Darkzveller/Stepper-Herkulex-CAN-F303K8/Kicad/CarteMPPIndus/ALTIUM_EMBEDDED_MODELS/LED 0603.STEP

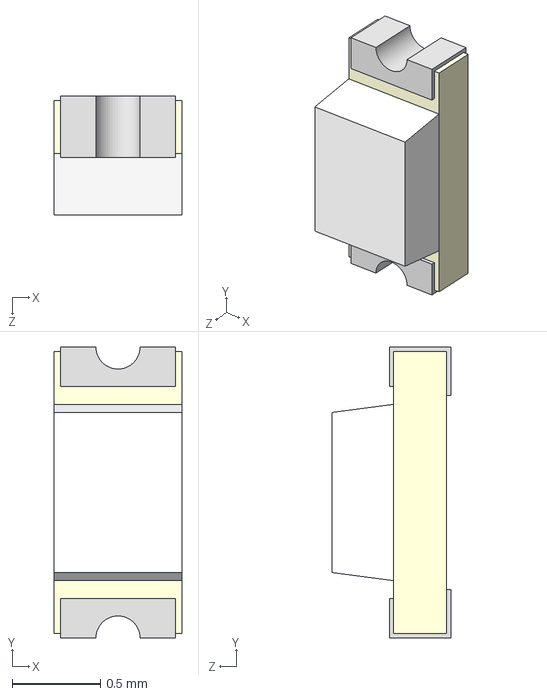
[picture p1: CAD file, 2025-05-03]
Kicad/CarteMPPIndus/ALTIUM_EMBEDDED_MODELS/LED 0603.STEP
0.725 x 1.65 x 0.675 mm
