Darkzveller/Stepper-Herkulex-CAN-F303K8/Kicad/CarteMPPIndus/LibGe2/3D/FTSH-105-01-L-DV-K.step

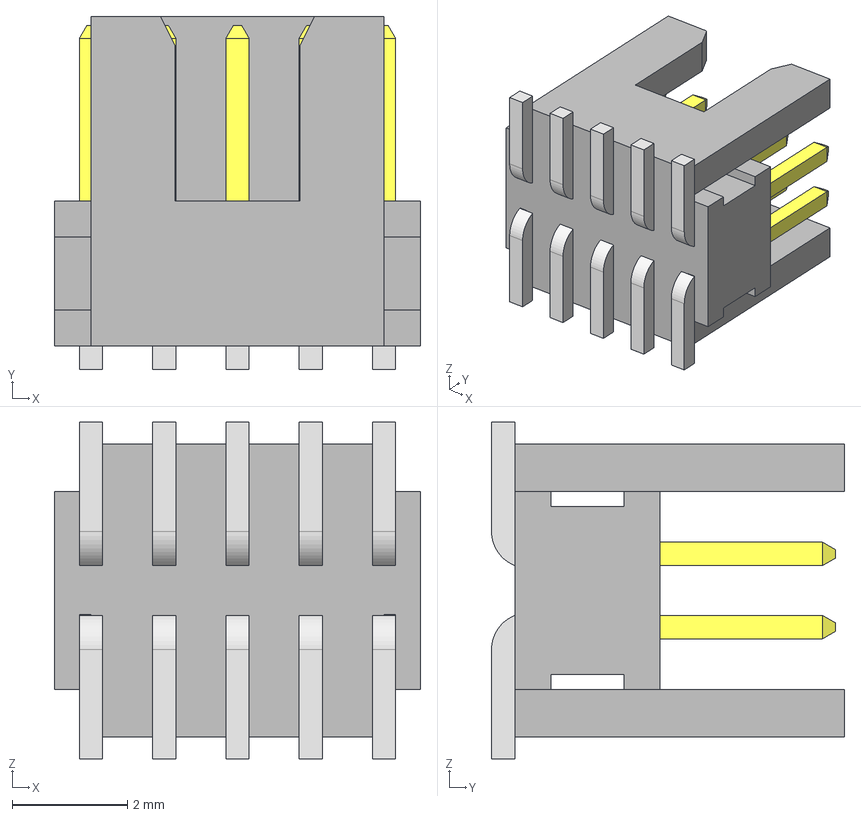
[picture p3: CAD file, 2025-05-03]
Kicad/CarteMPPIndus/LibGe2/3D/FTSH-105-01-L-DV-K.step
6.35 x 6.12 x 5.84 mm
FTSH-105-01-L-DV-K_body
FTSH-105-01-L-DV-K_pins1
FTSH-105-01-L-DV-K_pins2
