Darkzveller/Stepper-Herkulex-CAN-F303K8/Kicad/CarteMPPIndus/STM32F303K8T6/STM32F303K8T6.step

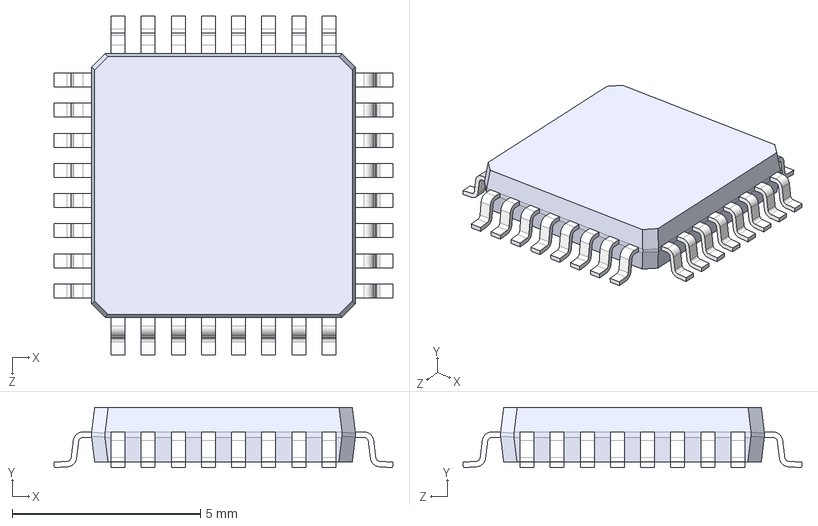
[picture p4: CAD file, 2025-05-03]
Kicad/CarteMPPIndus/STM32F303K8T6/STM32F303K8T6.step
9.00 x 1.60 x 9.00 mm
