Darkzveller/Stepper-Herkulex-CAN-F303K8/Kicad/CarteMPPIndus/STSPIN820/STSPIN820.step

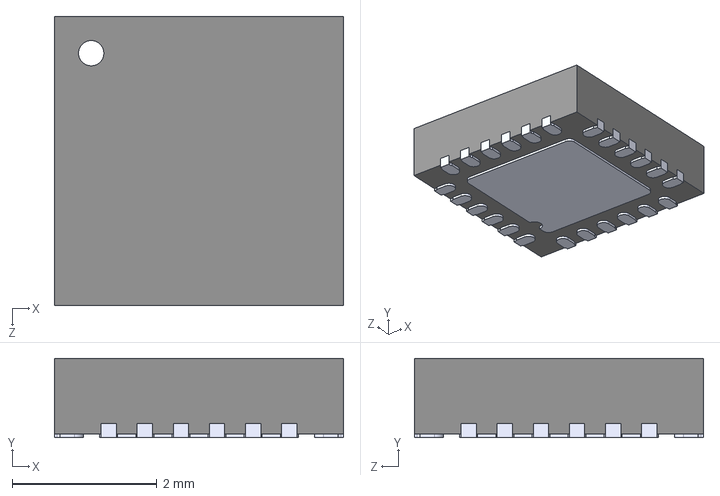
[picture p5: CAD file, 2025-05-03]
Kicad/CarteMPPIndus/STSPIN820/STSPIN820.step
4.00 x 1.10 x 4.00 mm
