Darkzveller/Stepper-Herkulex-CAN-F303K8/Kicad/Extension_Pompes/LibGamelGe2_v6/3D/BNC.STEP

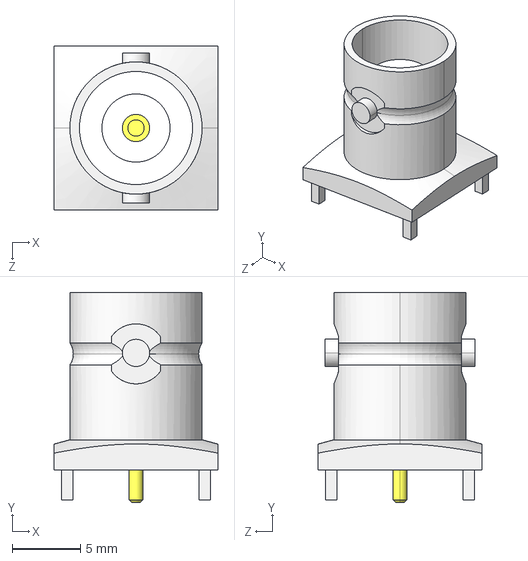
[picture p7: CAD file, 2025-02-12]
Kicad/Extension_Pompes/LibGamelGe2_v6/3D/BNC.STEP
12.0 x 15.4 x 12.0 mm
