Darkzveller/Stepper-Herkulex-CAN-F303K8/Kicad/Kicad_Pince KICAD V7/ALTIUM_EMBEDDED_MODELS/IC_Microchip_24LC1025T-I-SN_eec.STEP

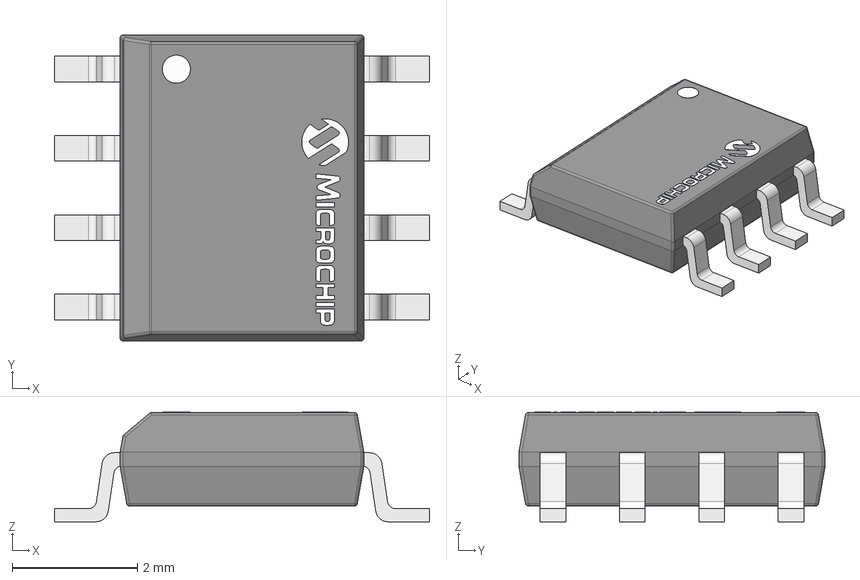
[picture p8: CAD file, 2025-02-12]
Kicad/Kicad_Pince KICAD V7/ALTIUM_EMBEDDED_MODELS/IC_Microchip_24LC1025T-I-SN_eec.STEP
6.00 x 4.90 x 1.75 mm
pins
logo1
