Darkzveller/Stepper-Herkulex-CAN-F303K8/Kicad/CarteMPPIndus/ALTIUM_EMBEDDED_MODELS/0603 SMD Resistor.stp

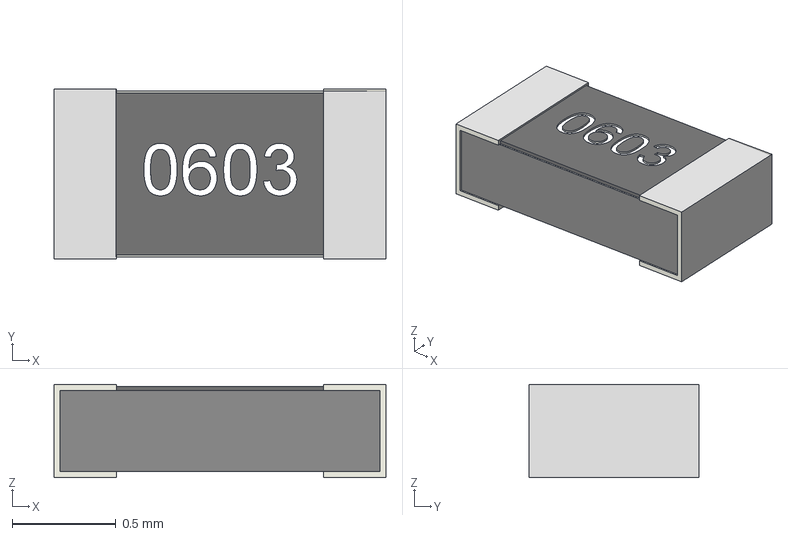
[picture p9: CAD file, 2025-05-03]
Kicad/CarteMPPIndus/ALTIUM_EMBEDDED_MODELS/0603 SMD Resistor.stp
1.60 x 0.82 x 0.45 mm
