Darkzveller/Stepper-Herkulex-CAN-F303K8/Kicad/Extension_Pompes/LibGamelGe2_v6/3D/OmnimateSL_1x04.STEP

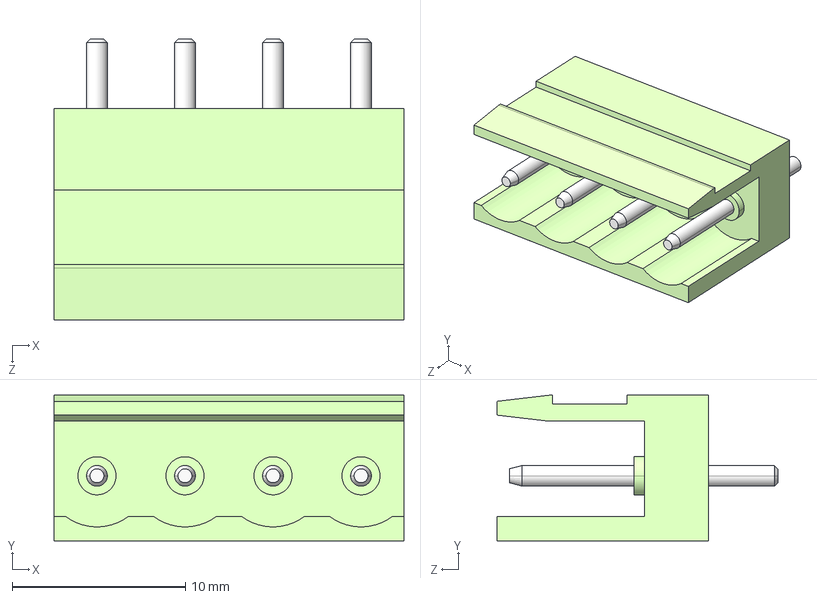
[picture p10: CAD file, 2025-02-12]
Kicad/Extension_Pompes/LibGamelGe2_v6/3D/OmnimateSL_1x04.STEP
20.2 x 8.40 x 16.2 mm
