Darkzveller/Stepper-Herkulex-CAN-F303K8/Kicad/CarteMPPIndus/ALTIUM_EMBEDDED_MODELS/User Library-SOIC-8-1.STEP

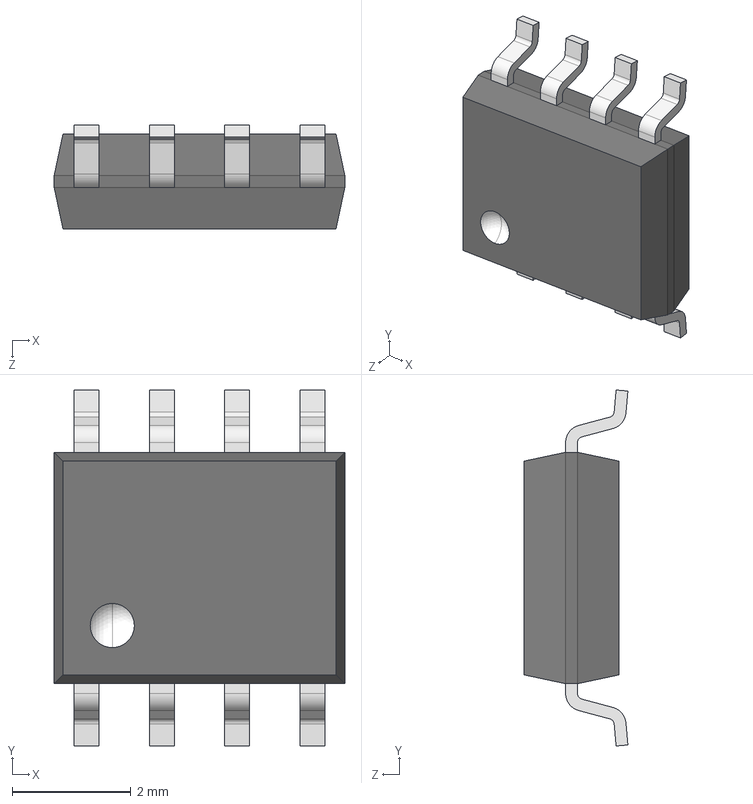
[picture p11: CAD file, 2025-05-03]
Kicad/CarteMPPIndus/ALTIUM_EMBEDDED_MODELS/User Library-SOIC-8-1.STEP
4.90 x 6.00 x 1.75 mm
