Darkzveller/Stepper-Herkulex-CAN-F303K8/Kicad/Extension_Pompes/LibGamelGe2_v6/3D/C_Rect_L19.0mm_W5.0mm_P15.00mm.STEP

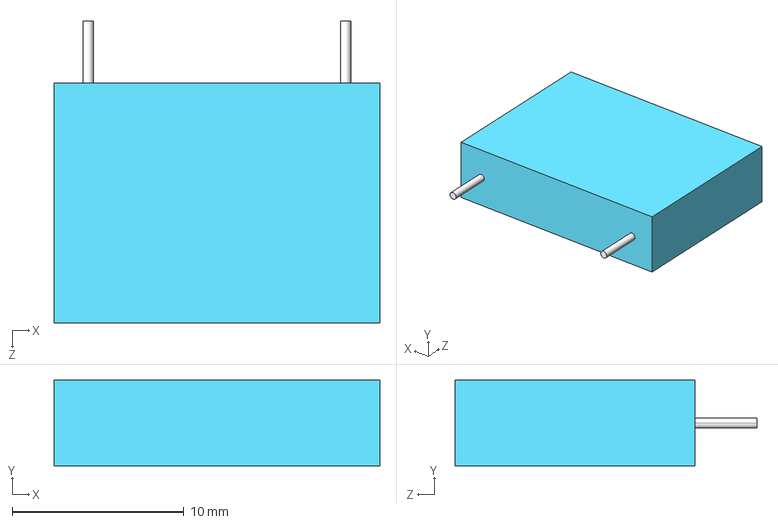
[picture p12: CAD file, 2025-02-12]
Kicad/Extension_Pompes/LibGamelGe2_v6/3D/C_Rect_L19.0mm_W5.0mm_P15.00mm.STEP
19.0 x 5.00 x 17.6 mm
