Darkzveller/Stepper-Herkulex-CAN-F303K8/Kicad/CarteMPPIndus/ALTIUM_EMBEDDED_MODELS/SOT95P240X110-3L.step

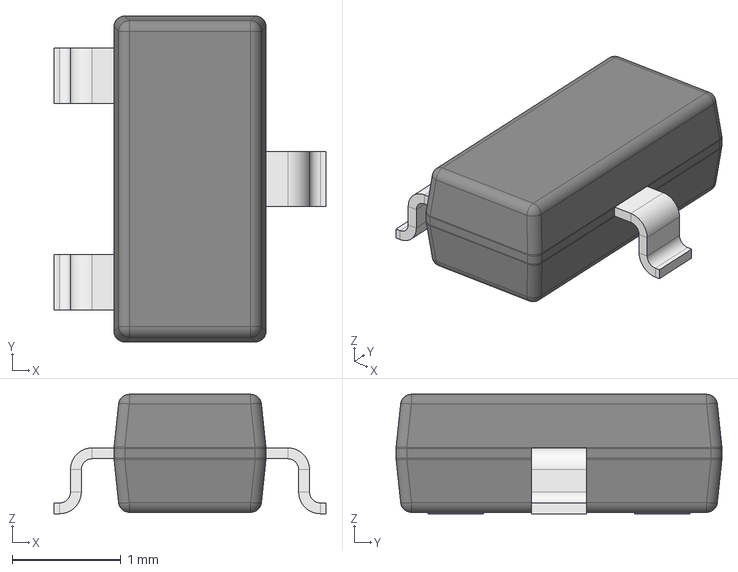
[picture p13: CAD file, 2025-05-03]
Kicad/CarteMPPIndus/ALTIUM_EMBEDDED_MODELS/SOT95P240X110-3L.step
2.50 x 3.00 x 1.10 mm
Leader x 3
