Darkzveller/Stepper-Herkulex-CAN-F303K8/Kicad/CarteMPPIndus/LibGe2/3D/Grove Connector (sit).STEP

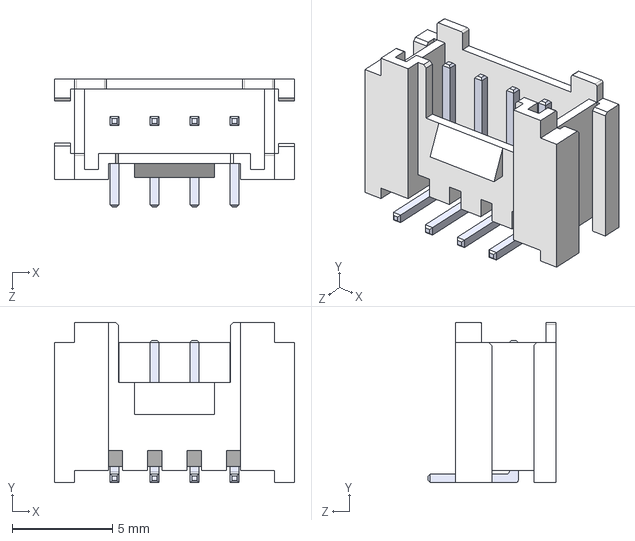
[picture p14: CAD file, 2025-02-12]
Kicad/CarteMPPIndus/LibGe2/3D/Grove Connector (sit).STEP
12.0 x 8.00 x 6.38 mm
