Darkzveller/Stepper-Herkulex-CAN-F303K8/Kicad/Extension_Pompes/LibGamelGe2_v6/3D/C_Rect_L4.0mm_W2.5mm_P2.50mm.STEP

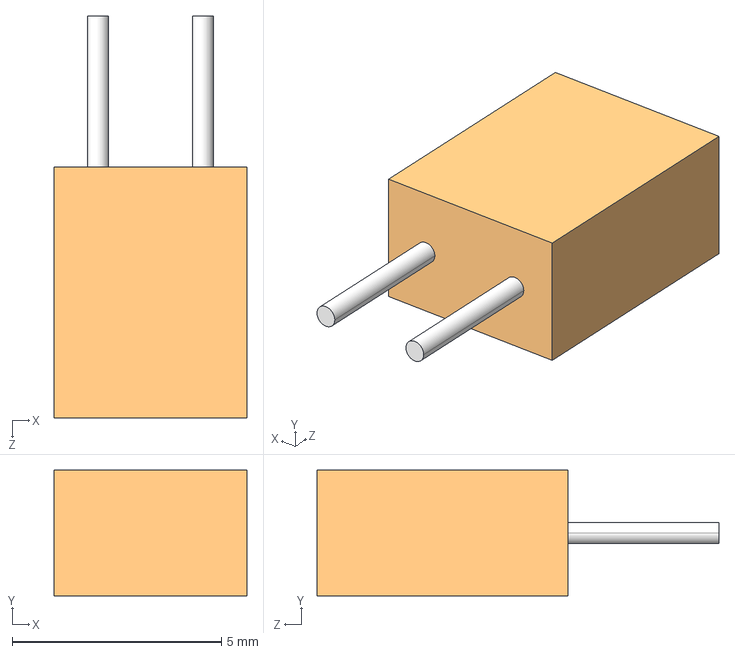
[picture p15: CAD file, 2025-02-12]
Kicad/Extension_Pompes/LibGamelGe2_v6/3D/C_Rect_L4.0mm_W2.5mm_P2.50mm.STEP
4.60 x 3.00 x 9.60 mm
