Darkzveller/Stepper-Herkulex-CAN-F303K8/Kicad/CarteMPPIndus/ALTIUM_EMBEDDED_MODELS/SW3dPS-SOT-223-1.STEP

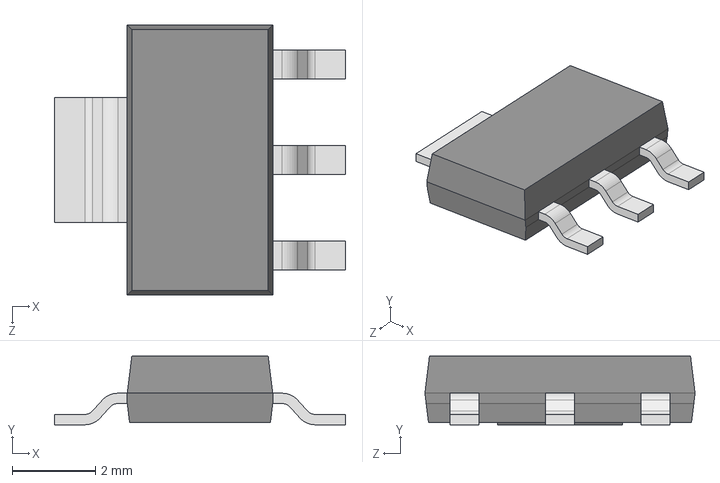
[picture p16: CAD file, 2025-05-03]
Kicad/CarteMPPIndus/ALTIUM_EMBEDDED_MODELS/SW3dPS-SOT-223-1.STEP
7.00 x 1.65 x 6.50 mm
