Darkzveller/Stepper-Herkulex-CAN-F303K8/Kicad/CarteMPPIndus/LibGe2/3D/pololu-2507.STEP

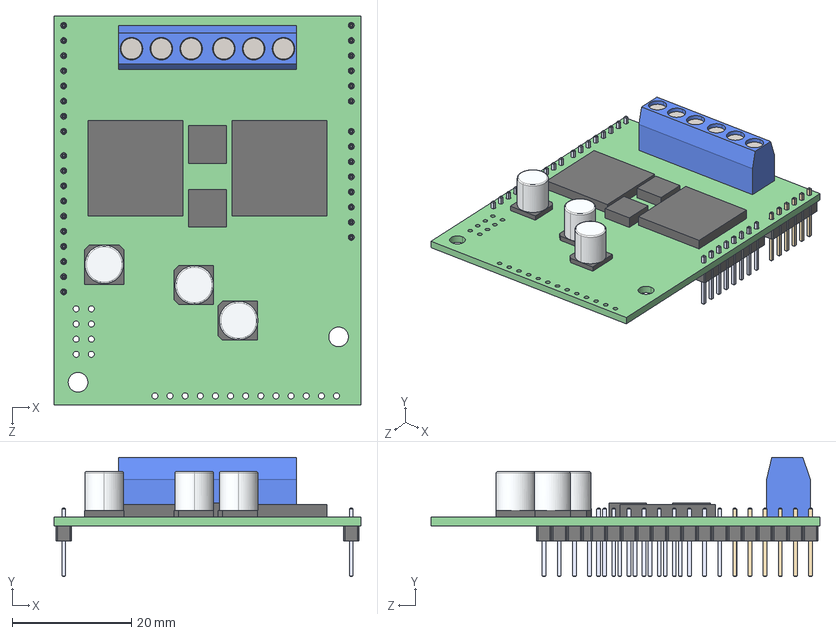
[picture p17: CAD file, 2025-02-12]
Kicad/CarteMPPIndus/LibGe2/3D/pololu-2507.STEP
51.4 x 20.0 x 65.3 mm
Pololu VNH5019 Motor Driver
PinHeader_1x06_P2.54mm_Vertical.step
PinHeader_1x08_P2.54mm_Vertical.step x 2
PinHeader_1x10_P2.54mm_Vertical.step
