Darkzveller/Stepper-Herkulex-CAN-F303K8/Kicad/Extension_Pompes/LibGamelGe2_v6/3D/SW_push_5mm_blue.STEP

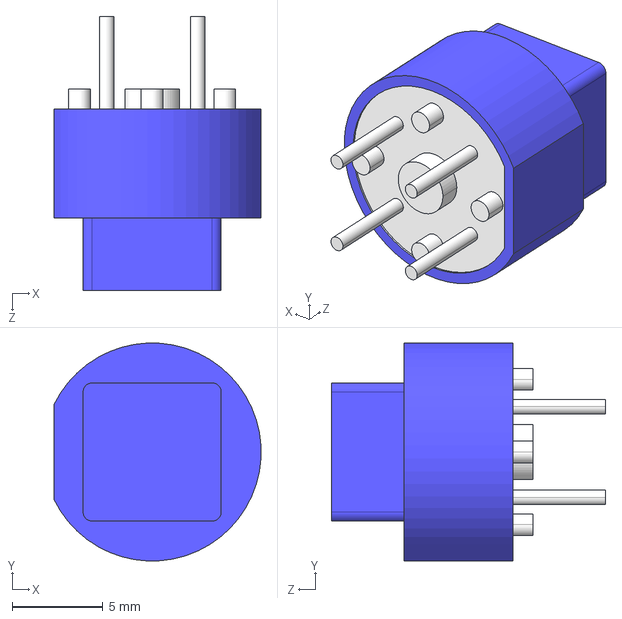
[picture p18: CAD file, 2025-02-12]
Kicad/Extension_Pompes/LibGamelGe2_v6/3D/SW_push_5mm_blue.STEP
11.4 x 12.0 x 15.1 mm
