Darkzveller/Stepper-Herkulex-CAN-F303K8/Kicad/CarteMPPIndus/ALTIUM_EMBEDDED_MODELS/Embase Micromatch Femelle CMS 8pts.stp

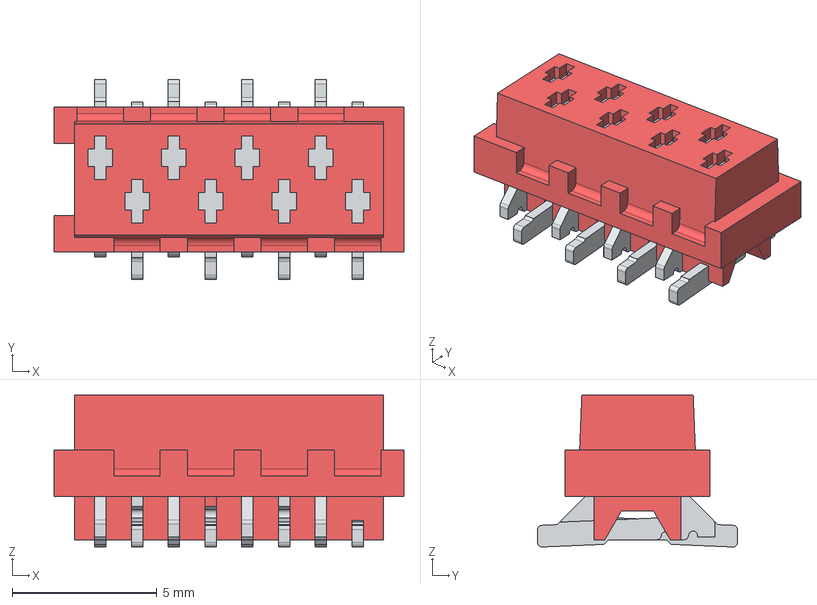
[picture p19: CAD file, 2025-02-12]
Kicad/CarteMPPIndus/ALTIUM_EMBEDDED_MODELS/Embase Micromatch Femelle CMS 8pts.stp
12.1 x 6.90 x 5.25 mm
