Darkzveller/Stepper-Herkulex-CAN-F303K8/Kicad/CarteMPPIndus/LibGe2/3D/Grove Connector (standing).STEP

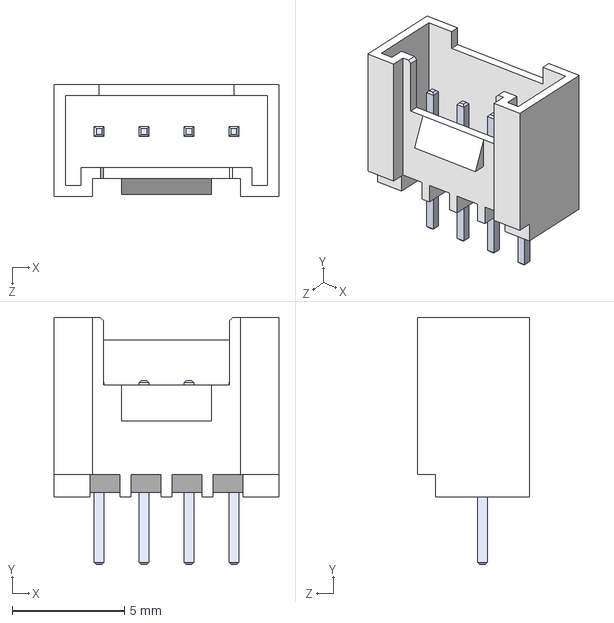
[picture p20: CAD file, 2025-02-12]
Kicad/CarteMPPIndus/LibGe2/3D/Grove Connector (standing).STEP
10.0 x 11.0 x 5.00 mm
