Darkzveller/Stepper-Herkulex-CAN-F303K8/Kicad/CarteMPPIndus/ALTIUM_EMBEDDED_MODELS/0603-C.STEP

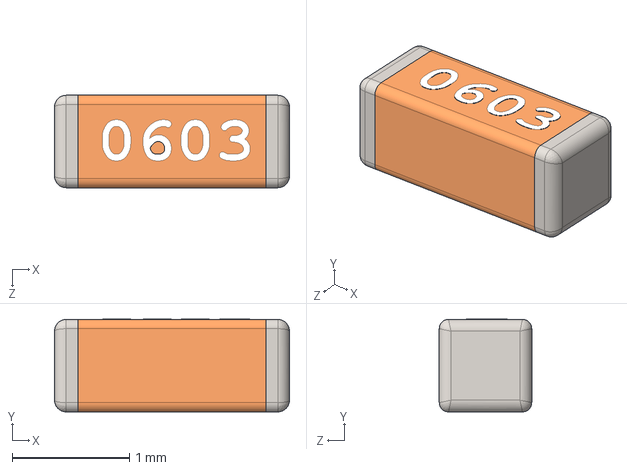
[picture p21: CAD file, 2025-02-12]
Kicad/CarteMPPIndus/ALTIUM_EMBEDDED_MODELS/0603-C.STEP
2.00 x 0.79 x 0.787 mm
