Darkzveller/Stepper-Herkulex-CAN-F303K8/Kicad/CarteMPPIndus/LibGe2/3D/Grove Connector (lying).STEP

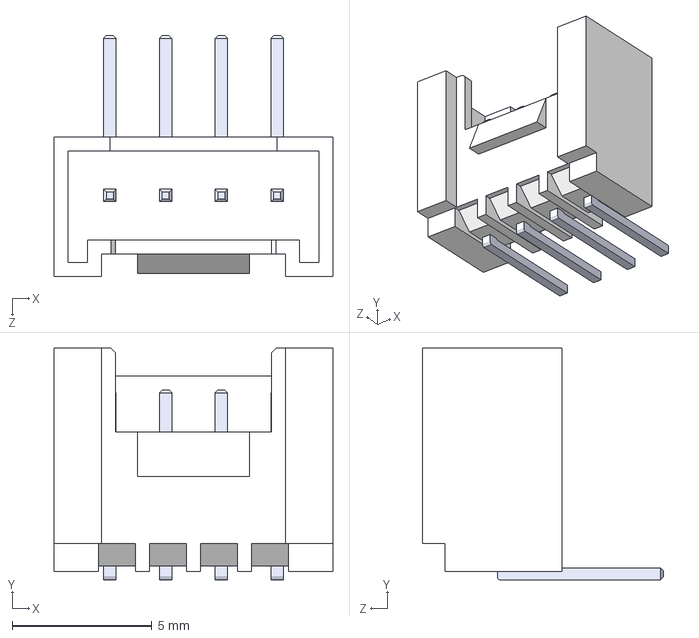
[picture p22: CAD file, 2025-02-12]
Kicad/CarteMPPIndus/LibGe2/3D/Grove Connector (lying).STEP
10.0 x 8.30 x 8.62 mm
