Darkzveller/Stepper-Herkulex-CAN-F303K8/Kicad/Extension_Pompes/LibGamelGe2_v6/3D/LED5mm_green.STEP

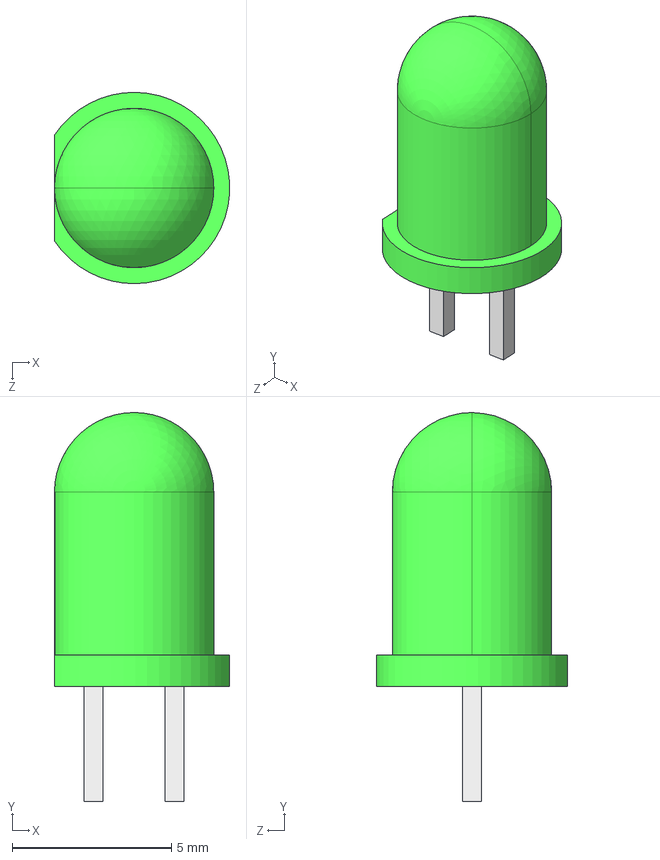
[picture p23: CAD file, 2025-02-12]
Kicad/Extension_Pompes/LibGamelGe2_v6/3D/LED5mm_green.STEP
5.49 x 12.2 x 6.00 mm
