Darkzveller/Stepper-Herkulex-CAN-F303K8/Kicad/CarteMPPIndus/LibGe2/3D/THN_15-1211N.step

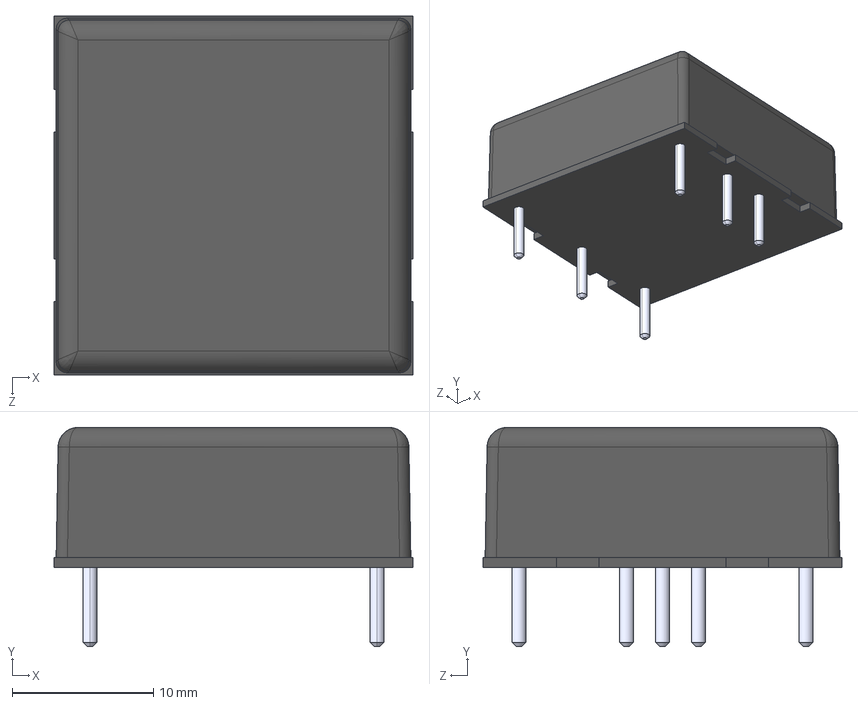
[picture p24: CAD file, 2025-02-12]
Kicad/CarteMPPIndus/LibGe2/3D/THN_15-1211N.step
25.4 x 15.5 x 25.4 mm
