Darkzveller/Stepper-Herkulex-CAN-F303K8/Kicad/Extension_Pompes/LibGamelGe2_v6/3D/HE10_2x8.STEP

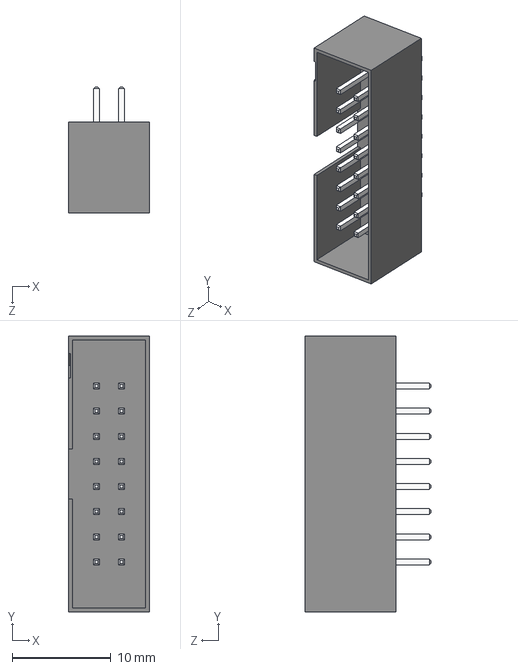
[picture p25: CAD file, 2025-02-12]
Kicad/Extension_Pompes/LibGamelGe2_v6/3D/HE10_2x8.STEP
8.20 x 27.9 x 12.7 mm
