Darkzveller/Stepper-Herkulex-CAN-F303K8/Kicad/CarteMPPIndus/LibGe2/3D/Grove Connector (flat).STEP

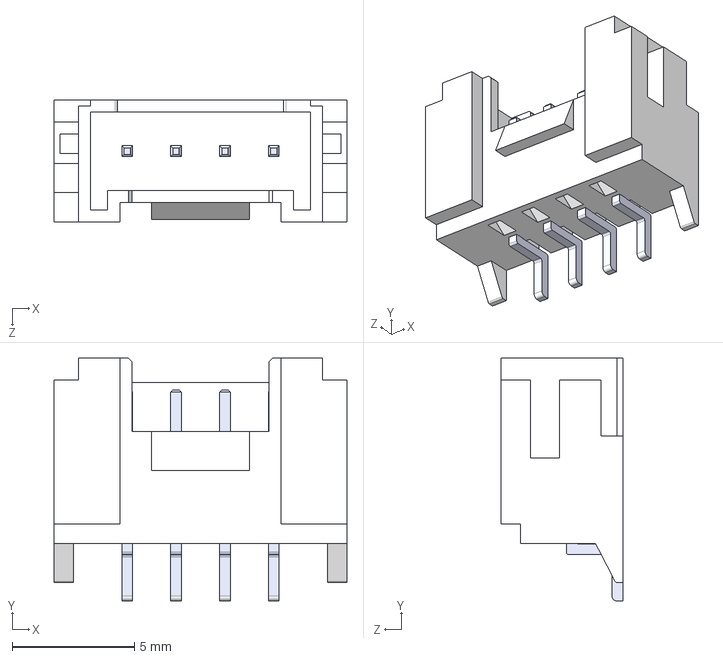
[picture p26: CAD file, 2025-02-12]
Kicad/CarteMPPIndus/LibGe2/3D/Grove Connector (flat).STEP
12.0 x 9.95 x 5.00 mm
