Darkzveller/Stepper-Herkulex-CAN-F303K8/Kicad/Extension_Pompes/LibGamelGe2_v6/3D/LED3mm_green.STEP

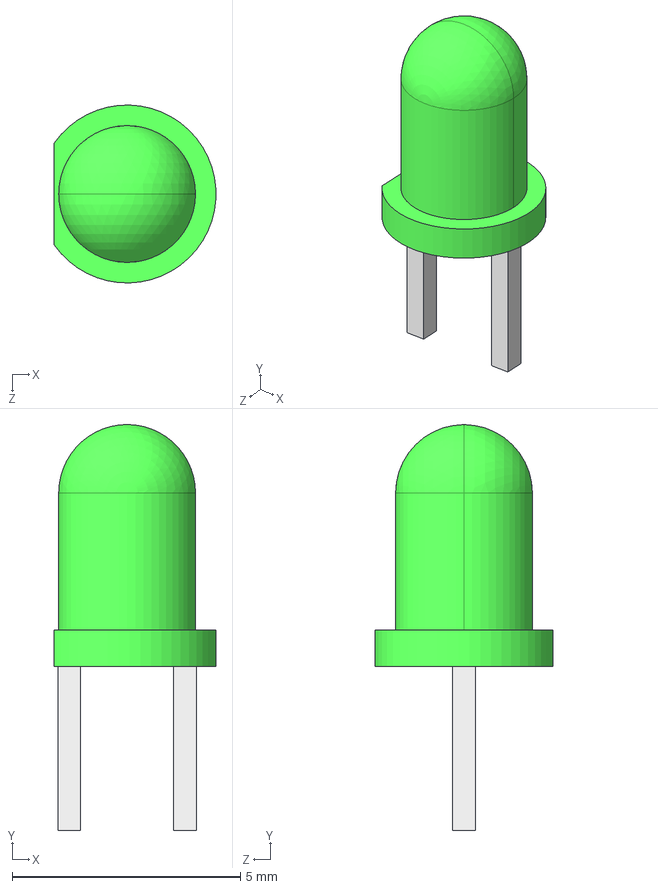
[picture p28: CAD file, 2025-02-12]
Kicad/Extension_Pompes/LibGamelGe2_v6/3D/LED3mm_green.STEP
3.55 x 8.90 x 3.90 mm
