Darkzveller/Stepper-Herkulex-CAN-F303K8/Kicad/Extension_Pompes/LibGamelGe2_v6/3D/C_Rect_L28.0mm_W8.0mm_P22.50mm.STEP

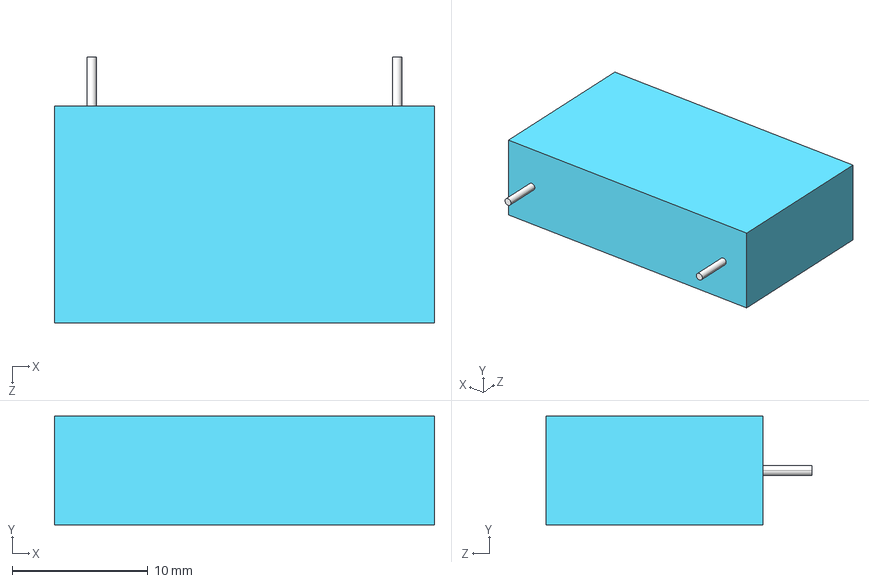
[picture p29: CAD file, 2025-02-12]
Kicad/Extension_Pompes/LibGamelGe2_v6/3D/C_Rect_L28.0mm_W8.0mm_P22.50mm.STEP
28.0 x 8.00 x 19.6 mm
