Darkzveller/Stepper-Herkulex-CAN-F303K8/Kicad/Extension_Pompes/LibGamelGe2_v6/3D/autocom4.STEP

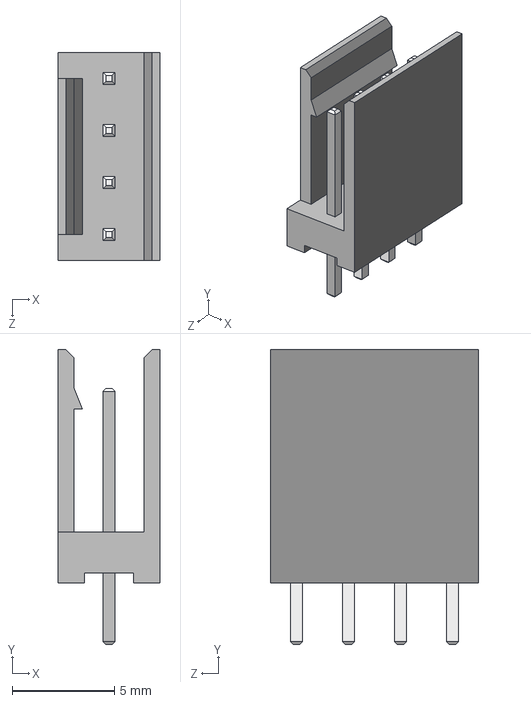
[picture p30: CAD file, 2025-02-12]
Kicad/Extension_Pompes/LibGamelGe2_v6/3D/autocom4.STEP
5.00 x 14.4 x 10.2 mm
