Darkzveller/Stepper-Herkulex-CAN-F303K8/Kicad/Extension_Pompes/LibGamelGe2_v6/3D/HE10_2x5.STEP

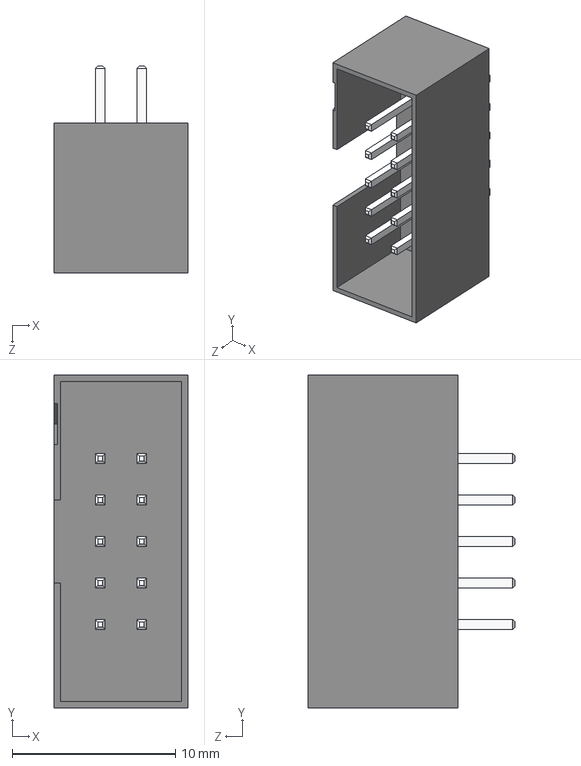
[picture p31: CAD file, 2025-02-12]
Kicad/Extension_Pompes/LibGamelGe2_v6/3D/HE10_2x5.STEP
8.20 x 20.4 x 12.7 mm
