Darkzveller/Stepper-Herkulex-CAN-F303K8/Kicad/Extension_Pompes/LibGamelGe2_v6/3D/TO220_horizontal.STEP

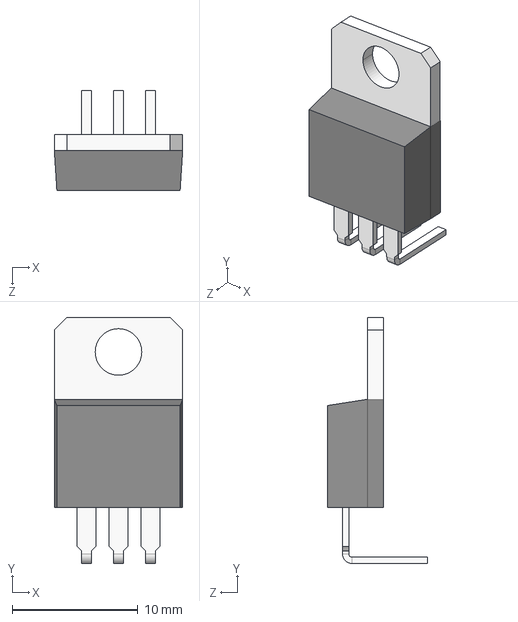
[picture p32: CAD file, 2025-02-12]
Kicad/Extension_Pompes/LibGamelGe2_v6/3D/TO220_horizontal.STEP
10.2 x 19.6 x 7.96 mm
