Darkzveller/Stepper-Herkulex-CAN-F303K8/Kicad/Extension_Pompes/LibGamelGe2_v6/3D/Potentiometer_Vertical.STEP

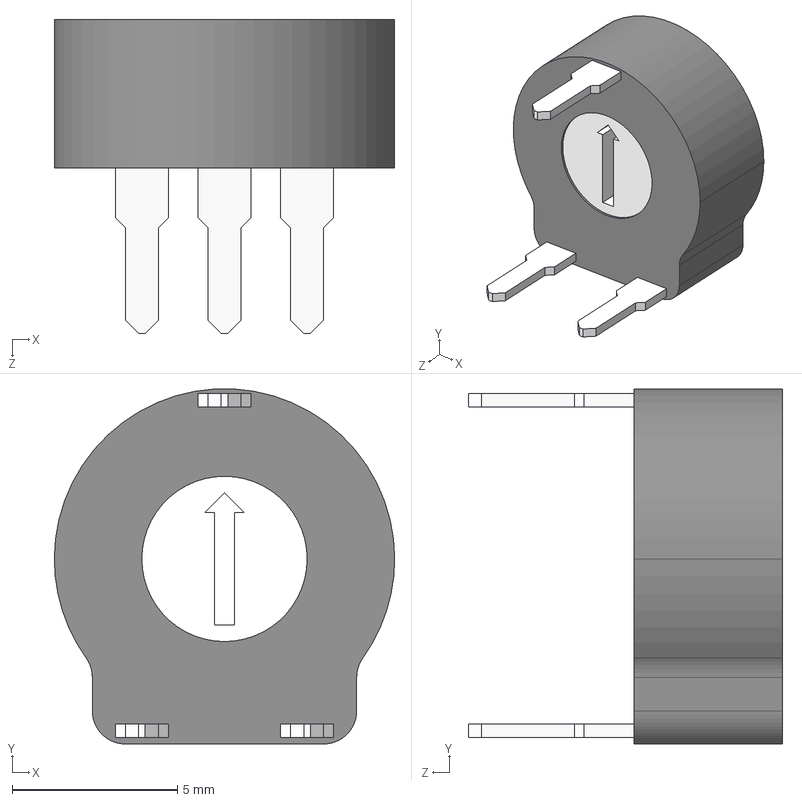
[picture p33: CAD file, 2025-02-12]
Kicad/Extension_Pompes/LibGamelGe2_v6/3D/Potentiometer_Vertical.STEP
10.3 x 10.7 x 9.50 mm
