Darkzveller/Stepper-Herkulex-CAN-F303K8/Kicad/Extension_Pompes/LibGamelGe2_v6/3D/OmnimateSL_1x02.STEP

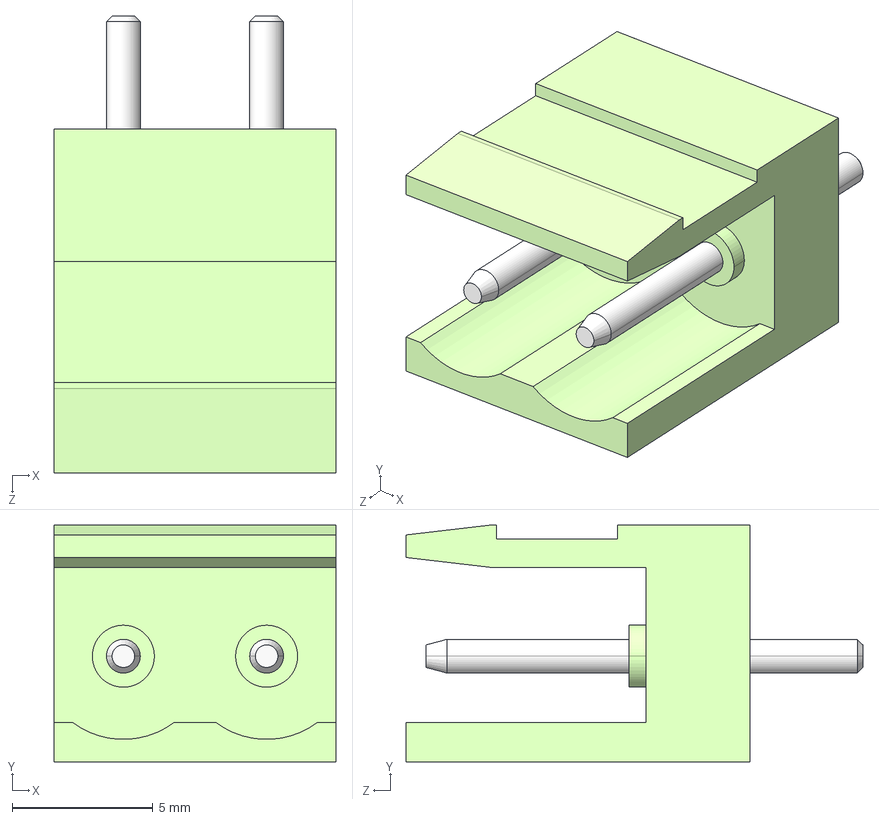
[picture p34: CAD file, 2025-02-12]
Kicad/Extension_Pompes/LibGamelGe2_v6/3D/OmnimateSL_1x02.STEP
10.0 x 8.40 x 16.2 mm
