Darkzveller/Stepper-Herkulex-CAN-F303K8/Kicad/Extension_Pompes/LibGamelGe2_v6/3D/C_Rect_L13.0mm_W5.0mm_P10.00mm.STEP

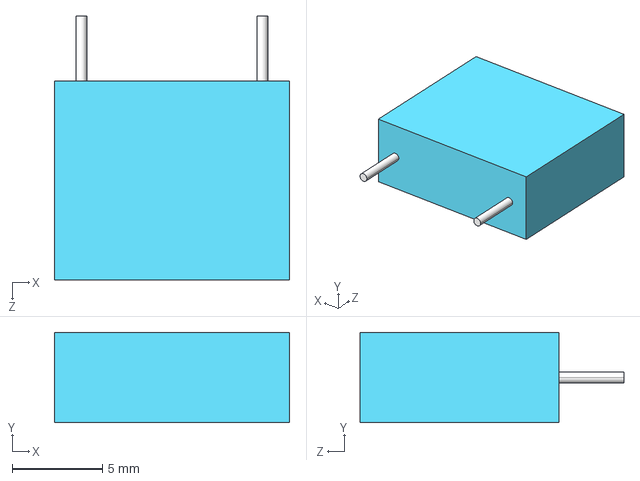
[picture p35: CAD file, 2025-02-12]
Kicad/Extension_Pompes/LibGamelGe2_v6/3D/C_Rect_L13.0mm_W5.0mm_P10.00mm.STEP
13.0 x 5.00 x 14.6 mm
