Darkzveller/Stepper-Herkulex-CAN-F303K8/Kicad/Extension_Pompes/LibGamelGe2_v6/3D/C_Rect_L10.0mm_W3.0mm_P7.50mm.STEP

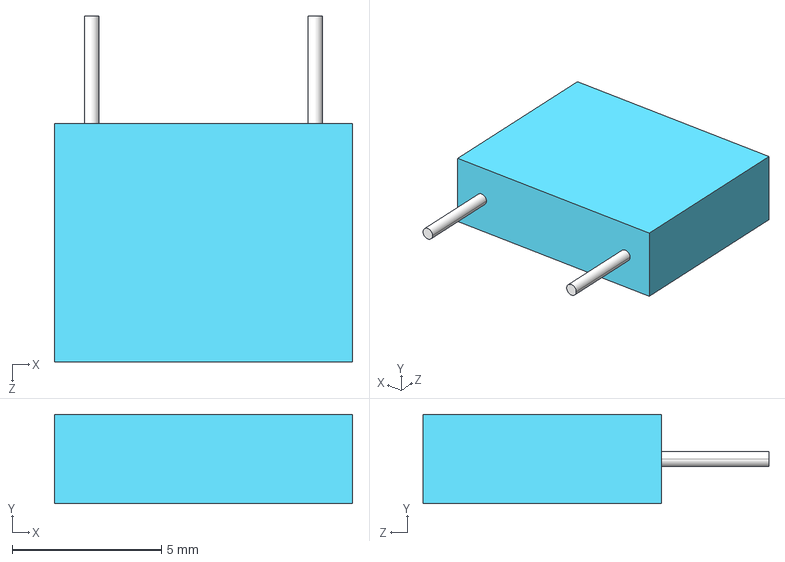
[picture p37: CAD file, 2025-02-12]
Kicad/Extension_Pompes/LibGamelGe2_v6/3D/C_Rect_L10.0mm_W3.0mm_P7.50mm.STEP
10.0 x 3.00 x 11.6 mm
