Darkzveller/Stepper-Herkulex-CAN-F303K8/Kicad/Extension_Pompes/LibGamelGe2_v6/3D/cny70.STEP

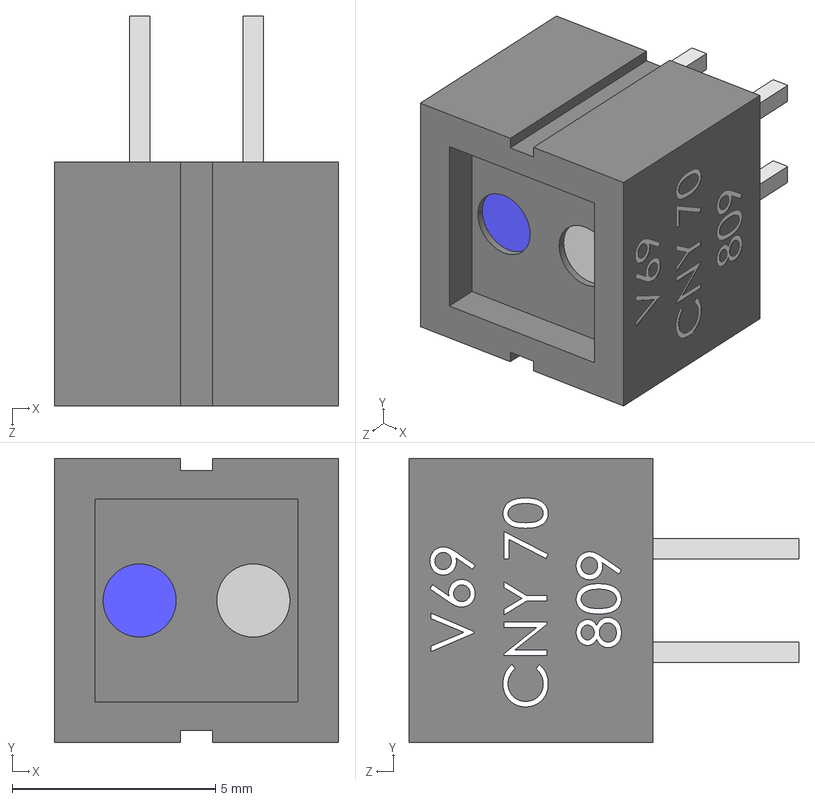
[picture p38: CAD file, 2025-02-12]
Kicad/Extension_Pompes/LibGamelGe2_v6/3D/cny70.STEP
7.00 x 7.00 x 9.60 mm
