Darkzveller/Stepper-Herkulex-CAN-F303K8/Kicad/Extension_Pompes/LibGamelGe2_v6/3D/C_Rect_L7.0mm_W2.5mm_P5.00mm.STEP

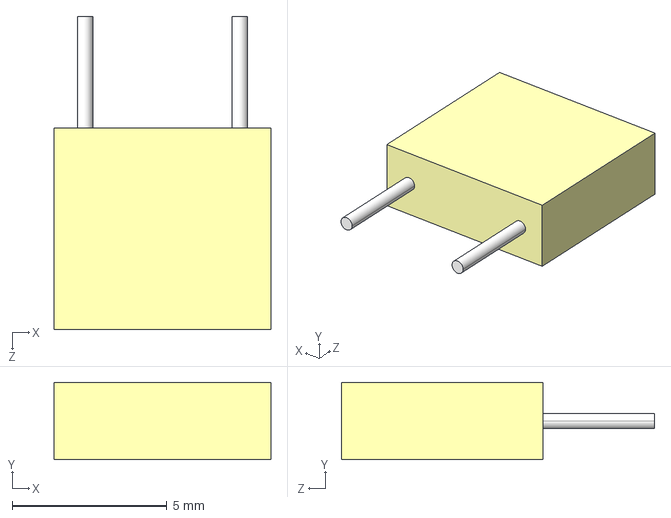
[picture p39: CAD file, 2025-02-12]
Kicad/Extension_Pompes/LibGamelGe2_v6/3D/C_Rect_L7.0mm_W2.5mm_P5.00mm.STEP
7.00 x 2.50 x 10.1 mm
