Darkzveller/Stepper-Herkulex-CAN-F303K8/Kicad/Extension_Pompes/LibGamelGe2_v6/3D/Potentiometer_Horizontal.STEP

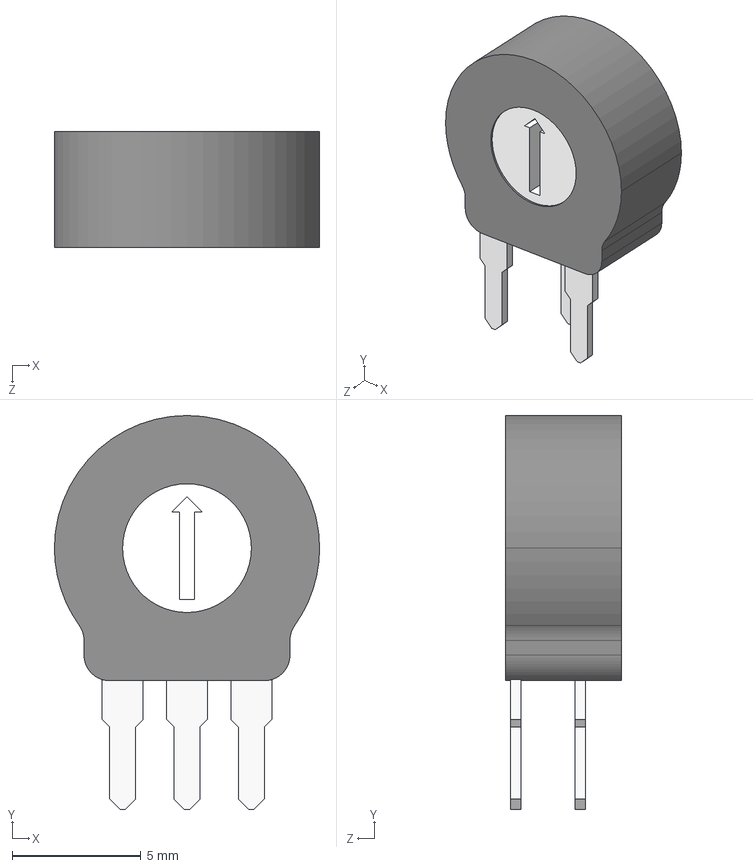
[picture p40: CAD file, 2025-02-12]
Kicad/Extension_Pompes/LibGamelGe2_v6/3D/Potentiometer_Horizontal.STEP
10.3 x 15.3 x 4.50 mm
