Darkzveller/Stepper-Herkulex-CAN-F303K8/Kicad/Extension_Pompes/LibGamelGe2_v6/3D/autocom5.STEP

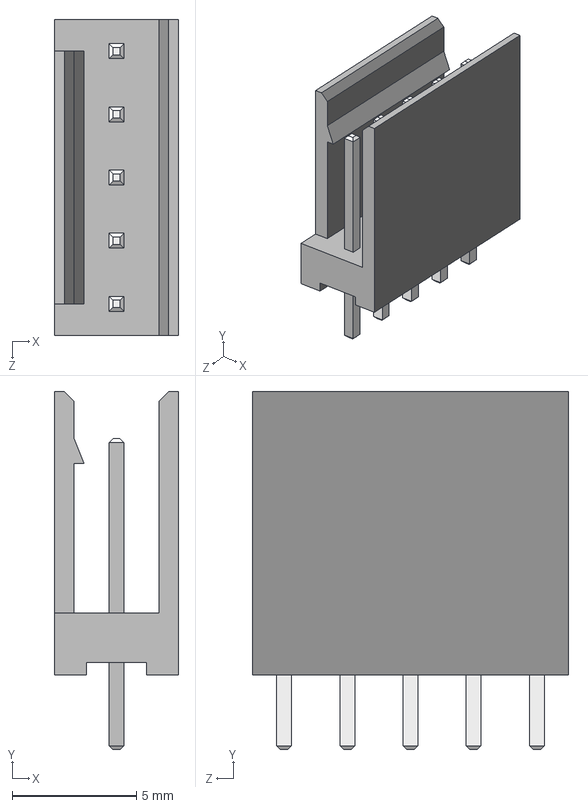
[picture p41: CAD file, 2025-02-12]
Kicad/Extension_Pompes/LibGamelGe2_v6/3D/autocom5.STEP
5.00 x 14.4 x 12.7 mm
