Darkzveller/Stepper-Herkulex-CAN-F303K8/Kicad/Extension_Pompes/LibGamelGe2_v6/3D/HE10_2x10.STEP

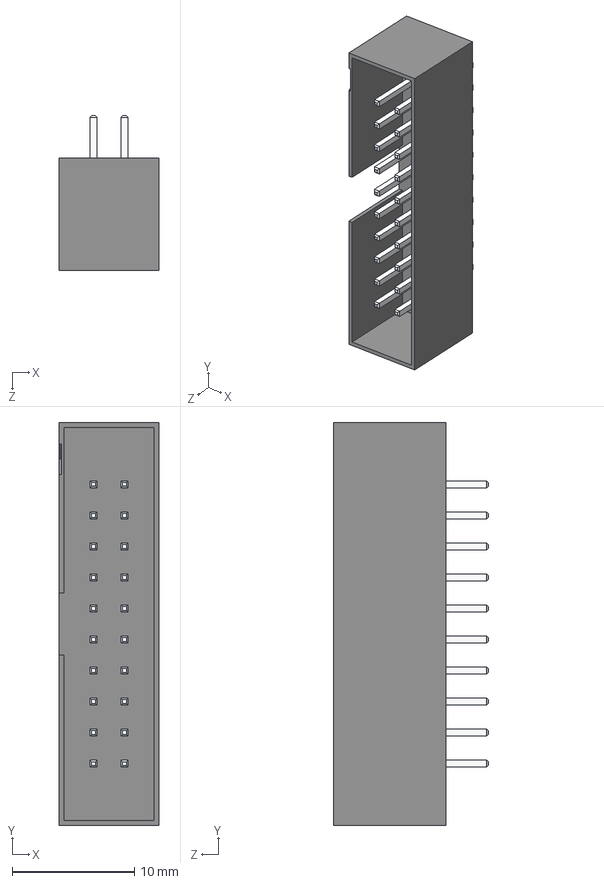
[picture p42: CAD file, 2025-02-12]
Kicad/Extension_Pompes/LibGamelGe2_v6/3D/HE10_2x10.STEP
8.20 x 33.0 x 12.7 mm
