Darkzveller/Stepper-Herkulex-CAN-F303K8/Kicad/Extension_Pompes/LibGamelGe2_v6/3D/DO35_7.62mm.STEP

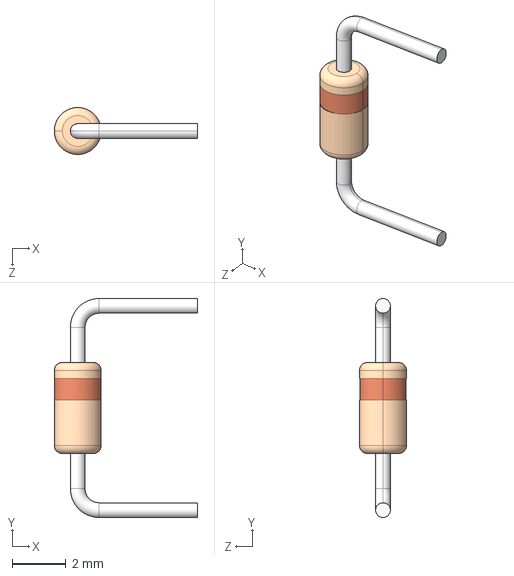
[picture p43: CAD file, 2025-02-12]
Kicad/Extension_Pompes/LibGamelGe2_v6/3D/DO35_7.62mm.STEP
5.35 x 8.17 x 1.75 mm
