Darkzveller/Stepper-Herkulex-CAN-F303K8/Kicad/Extension_Pompes/LibGamelGe2_v6/3D/TO220_vertical.STEP

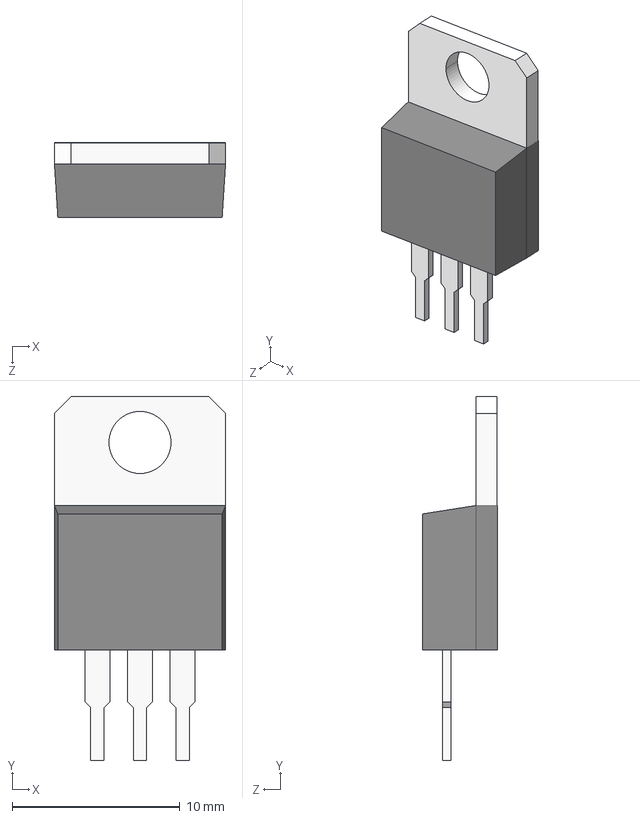
[picture p44: CAD file, 2025-02-12]
Kicad/Extension_Pompes/LibGamelGe2_v6/3D/TO220_vertical.STEP
10.2 x 21.7 x 4.46 mm
