Darkzveller/Stepper-Herkulex-CAN-F303K8/Kicad/Extension_Pompes/LibGamelGe2_v6/3D/autocom2.STEP

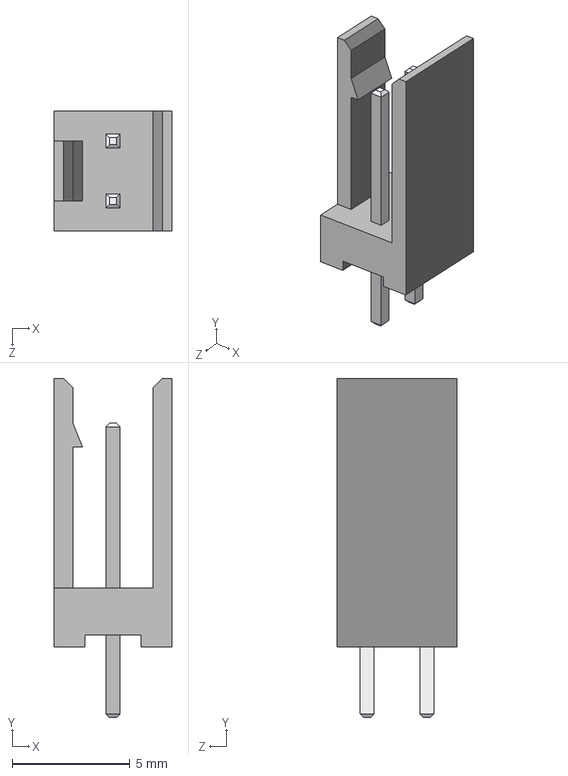
[picture p45: CAD file, 2025-02-12]
Kicad/Extension_Pompes/LibGamelGe2_v6/3D/autocom2.STEP
5.00 x 14.4 x 5.08 mm
