Darkzveller/Stepper-Herkulex-CAN-F303K8/(list of files, cad)

Other CAD files:
Kicad/Extension_Pompes/LibGamelGe2_v6/3D/SW_push_5mm_red.STEP
Kicad/Extension_Pompes/LibGamelGe2_v6/3D/LED3mm_red.STEP
Kicad/Extension_Pompes/LibGamelGe2_v6/3D/LED5mm_orange.STEP
Kicad/Extension_Pompes/LibGamelGe2_v6/3D/SW_push_5mm_green.STEP
Kicad/Extension_Pompes/LibGamelGe2_v6/3D/LED3mm_orange.STEP
Kicad/Extension_Pompes/LibGamelGe2_v6/3D/LED5mm_red.STEP
Kicad/Ancien_Kicad_Pince KICAD V7/LibGe2/3D/110990030.step
Kicad/Ancien_Kicad_Pince KICAD V7/LibGe2/3D/Grove Connector (flat).SLDPRT
Kicad/Ancien_Kicad_Pince KICAD V7/LibGe2/3D/Grove Connector (lying).SLDPRT
Kicad/Ancien_Kicad_Pince KICAD V7/LibGe2/3D/Grove Connector (sit).SLDPRT
Kicad/Ancien_Kicad_Pince KICAD V7/LibGe2/3D/Grove Connector (standing).SLDPRT
Kicad/CarteMPPIndus/LibGe2/3D/110990030.step
Kicad/CarteMPPIndus/LibGe2/3D/292161-4.step
Kicad/CarteMPPIndus/LibGe2/3D/Grove Connector (flat).SLDPRT
Kicad/CarteMPPIndus/LibGe2/3D/Grove Connector (lying).SLDPRT
Kicad/CarteMPPIndus/LibGe2/3D/Grove Connector (sit).SLDPRT
Kicad/CarteMPPIndus/LibGe2/3D/Grove Connector (standing).SLDPRT
Kicad/Extension_Pompes/LibGamelGe2_v6/3D/BNC.SLDPRT
Kicad/Extension_Pompes/LibGamelGe2_v6/3D/C_Rect_L10.0mm_W3.0mm_P7.50mm.SLDPRT
Kicad/Extension_Pompes/LibGamelGe2_v6/3D/C_Rect_L13.0mm_W5.0mm_P10.00mm.SLDPRT
Kicad/Extension_Pompes/LibGamelGe2_v6/3D/C_Rect_L19.0mm_W5.0mm_P15.00mm.SLDPRT
Kicad/Extension_Pompes/LibGamelGe2_v6/3D/C_Rect_L28.0mm_W8.0mm_P22.50mm.SLDPRT
Kicad/Extension_Pompes/LibGamelGe2_v6/3D/C_Rect_L4.0mm_W2.5mm_P2.50mm.SLDPRT
Kicad/Extension_Pompes/LibGamelGe2_v6/3D/C_Rect_L7.0mm_W2.5mm_P5.00mm.SLDPRT
Kicad/Extension_Pompes/LibGamelGe2_v6/3D/DO35_7.62mm.SLDPRT
Kicad/Extension_Pompes/LibGamelGe2_v6/3D/HE10_2x10.SLDPRT
Kicad/Extension_Pompes/LibGamelGe2_v6/3D/HE10_2x5.SLDPRT
Kicad/Extension_Pompes/LibGamelGe2_v6/3D/HE10_2x8.SLDPRT
Kicad/Extension_Pompes/LibGamelGe2_v6/3D/LED3mm_green.SLDPRT
Kicad/Extension_Pompes/LibGamelGe2_v6/3D/LED3mm_orange.SLDPRT
Kicad/Extension_Pompes/LibGamelGe2_v6/3D/LED3mm_red.SLDPRT
Kicad/Extension_Pompes/LibGamelGe2_v6/3D/LED5mm_green.SLDPRT
Kicad/Extension_Pompes/LibGamelGe2_v6/3D/LED5mm_orange.SLDPRT
Kicad/Extension_Pompes/LibGamelGe2_v6/3D/LED5mm_red.SLDPRT
Kicad/Extension_Pompes/LibGamelGe2_v6/3D/OmnimateSL_1x02.SLDPRT
Kicad/Extension_Pompes/LibGamelGe2_v6/3D/OmnimateSL_1x04.SLDPRT
Kicad/Extension_Pompes/LibGamelGe2_v6/3D/Potentiometer_Horizontal.SLDPRT
Kicad/Extension_Pompes/LibGamelGe2_v6/3D/Potentiometer_Vertical.SLDPRT
Kicad/Extension_Pompes/LibGamelGe2_v6/3D/R_Axial_L6.3mm_D2.5mm_P10.16mm_Horizontal.SLDPRT
Kicad/Extension_Pompes/LibGamelGe2_v6/3D/SW_push_5mm_blue.SLDPRT
Kicad/Extension_Pompes/LibGamelGe2_v6/3D/SW_push_5mm_green.SLDPRT
Kicad/Extension_Pompes/LibGamelGe2_v6/3D/SW_push_5mm_red.SLDPRT
Kicad/Extension_Pompes/LibGamelGe2_v6/3D/Screw_3mm.SLDASM
Kicad/Extension_Pompes/LibGamelGe2_v6/3D/Screw_3mm.SLDPRT
Kicad/Extension_Pompes/LibGamelGe2_v6/3D/Screw_3mm.STEP
Kicad/Extension_Pompes/LibGamelGe2_v6/3D/TO220_horizontal.SLDPRT
Kicad/Extension_Pompes/LibGamelGe2_v6/3D/TO220_vertical.SLDPRT
Kicad/Extension_Pompes/LibGamelGe2_v6/3D/autocom2.SLDPRT
Kicad/Extension_Pompes/LibGamelGe2_v6/3D/autocom3.SLDPRT
Kicad/Extension_Pompes/LibGamelGe2_v6/3D/autocom4.SLDPRT
Kicad/Extension_Pompes/LibGamelGe2_v6/3D/autocom5.SLDPRT
Kicad/Extension_Pompes/LibGamelGe2_v6/3D/cny70.SLDPRT
