Darkzveller/Stepper-Herkulex-CAN-F303K8/(commit log)

2025-02-12 Code STEPPER Fonctionnel
2025-02-12 Validation fonctionnement Stepper
2025-02-12 Fonctionnement nickel des servo moteur
2025-02-13 Stepper + Herkulex c'est bon
2025-02-20 Une partie de la bibliotheque CAN codé
2025-04-13 ajout acquisition pos servo
2025-04-13 oubli de proto fcn
2025-04-17 Ajout de la tâche construction : c'est une tâche qui se réveille après une notification et qui meurt une fois la construction terminée. En gros la tâche bouffe pas de CPU tant qu'elle est pas demandé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
2025-04-18 Ajout d'une fonction pour avoir la position d'un servo moteur à la fois au lieu d'avoir tout le monde en même temps. Déplacement de la déclaration des objets Herkulex dans HERKULEX.h pour y avoi accè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
2025-04-18 Ajout de la tahce pour constuire sans mutex
2025-04-18 Base de la fonction pour construire 2 étages ! Quelques trucs à améliorer notamment les conditions étant donnné qu'il me manque des infos dessus. Enfin, étant donné que je ne connais pas le fonctionn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
2025-05-03 Mise a jour du dossier kicad Carte MPP_Indus
    [0603 SMD Resistor.stp, 0603-C.STEP, 110990030.step, 292161-4.step, BNC.SLDPRT, BNC.STEP, C_Rect_L10.0mm_W3.0mm_P7.50mm.SLDPRT, C_Rect_L10.0mm_W3.0mm_P7.50mm.STEP]
2025-05-03 Ajout du zip du Kicad Carte MPP Indus
2025-05-04 Test du code de la commande de la pompe + ajout kicad Extension pompe normal et zipper
    [BNC.SLDPRT, BNC.STEP, C_Rect_L10.0mm_W3.0mm_P7.50mm.SLDPRT, C_Rect_L10.0mm_W3.0mm_P7.50mm.STEP, C_Rect_L13.0mm_W5.0mm_P10.00mm.SLDPRT, C_Rect_L13.0mm_W5.0mm_P10.00mm.STEP, C_Rect_L19.0mm_W5.0mm_P15.00mm.SLDPRT, C_Rect_L19.0mm_W5.0mm_P15.00mm.STEP]
2025-05-04 Etant donnée que j'envoyé des commandes depuis le sniffer can, j'ai dit dans le platform io d'ouvrir le moniteur série non sur l'esp32 mais sur la carte MPP + Réglage de la distance lorsque le MPP do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
2025-05-04 Modification de l'ID CAN de START Robot match et ARU car il rentrait en conflit mutuellement
