Darkzveller/Stepper-Herkulex-CAN-F303K8/(notices)

Notices in the files:
Kicad/CarteMPPIndus/LibGe2/3D/FTSH-105-01-L-DV-K.step:
author */ ('License CC BY-ND 4.0'),
